meco0597/SeniorProject/Shell/DXFs/24tooth/24tooth_2.05mm_0.15mmkerf.dxf

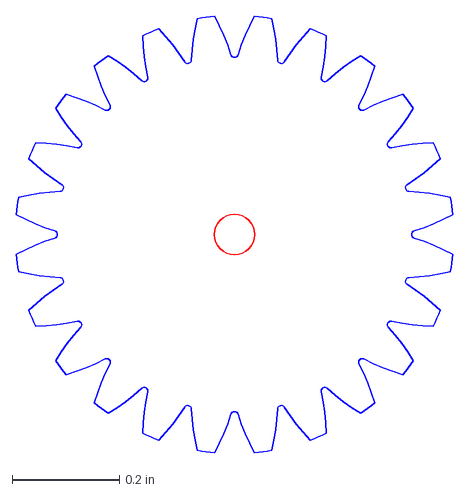
[picture p8: CAD file, 2019-11-20]
Shell/DXFs/24tooth/24tooth_2.05mm_0.15mmkerf.dxf
0.813 x 0.813 in
