meco0597/SeniorProject/Shell/Parts/Wheel_Acrylic.stl

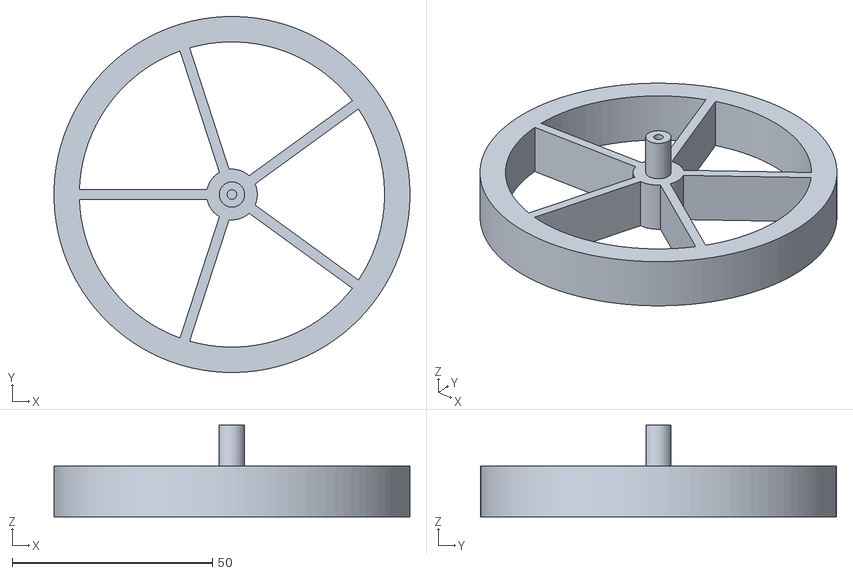
[picture p9: CAD file, 2019-11-24]
Shell/Parts/Wheel_Acrylic.stl
88.9 x 88.9 x 22.9
