meco0597/SeniorProject/Shell/STLs/Ramp.stl

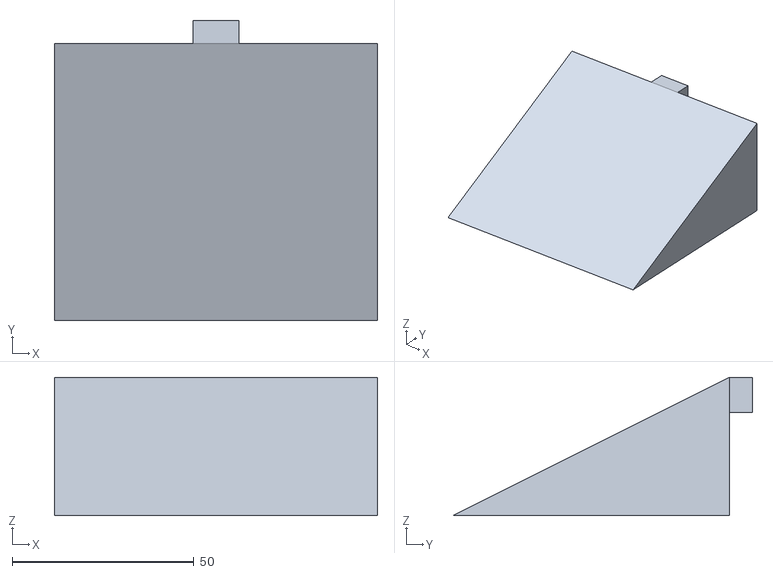
[picture p10: CAD file, 2019-12-04]
Shell/STLs/Ramp.stl
88.9 x 82.5 x 38.1
