meco0597/SeniorProject/Shell/DXFs/12tooth/12tooth_2.05mm_0.18mmkerf.dxf

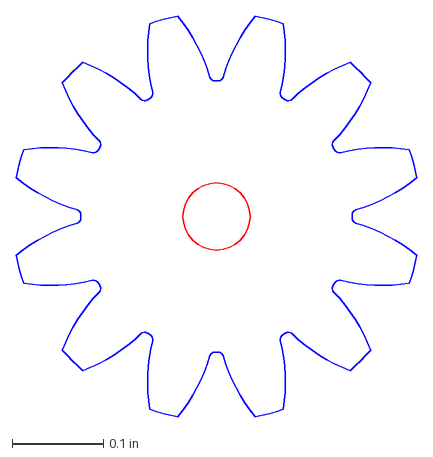
[picture p11: CAD file, 2019-11-20]
Shell/DXFs/12tooth/12tooth_2.05mm_0.18mmkerf.dxf
0.439 x 0.439 in
