meco0597/SeniorProject/Shell/Parts/GearPlate_Acrylic.stl

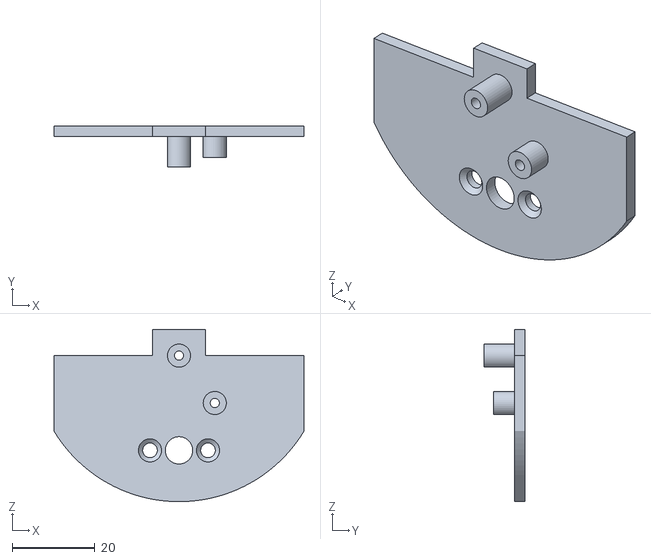
[picture p13: CAD file, 2019-11-23]
Shell/Parts/GearPlate_Acrylic.stl
60.3 x 10.0 x 41.6
