meco0597/SeniorProject/Shell/DXFs/24tooth/24tooth_2.05mm_0.18mmkerf.dxf

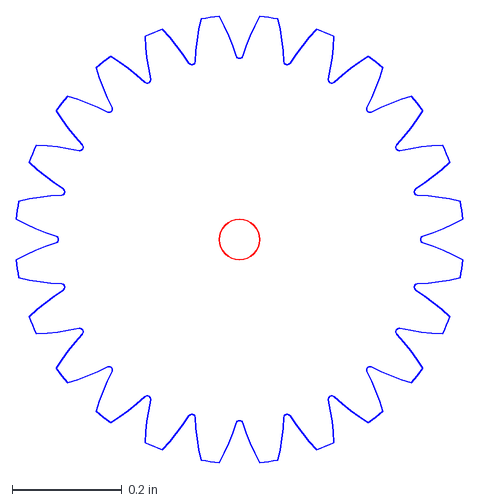
[picture p15: CAD file, 2019-11-20]
Shell/DXFs/24tooth/24tooth_2.05mm_0.18mmkerf.dxf
0.814 x 0.814 in
