meco0597/SeniorProject/Shell/STLs/GearPlateMini.stl

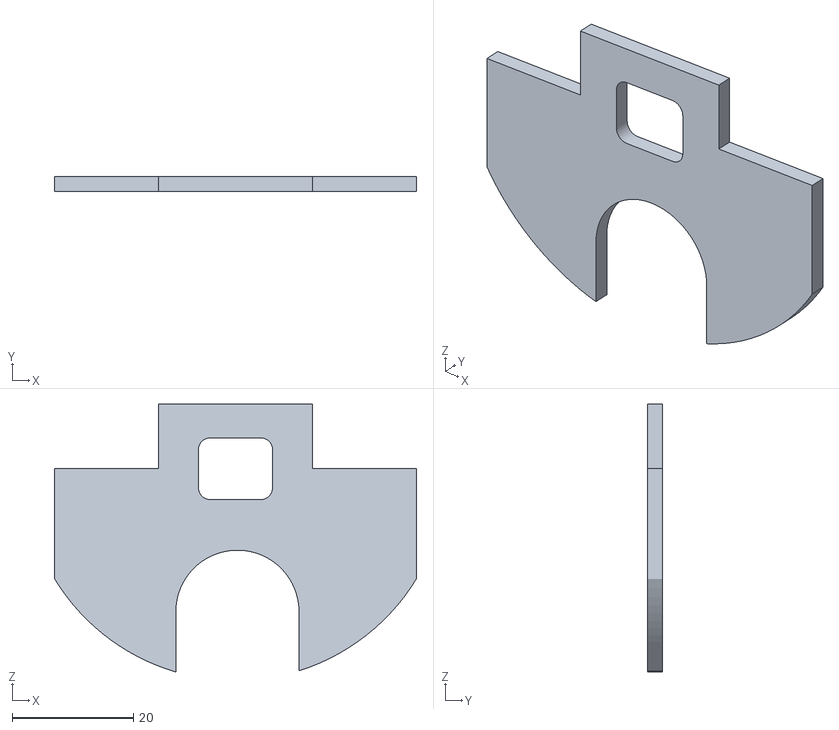
[picture p16: CAD file, 2019-12-03]
Shell/STLs/GearPlateMini.stl
59.7 x 2.54 x 44.2
