meco0597/SeniorProject/Shell/DXFs/12tooth/12tooth_0.20mmkerf.dxf

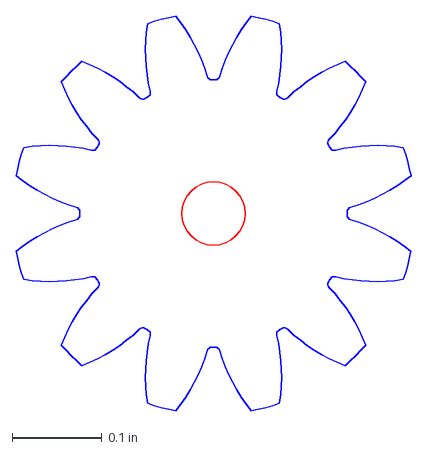
[picture p17: CAD file, 2019-11-20]
Shell/DXFs/12tooth/12tooth_0.20mmkerf.dxf
0.44 x 0.44 in
