meco0597/SeniorProject/Shell/STLs/MotorGear.stl

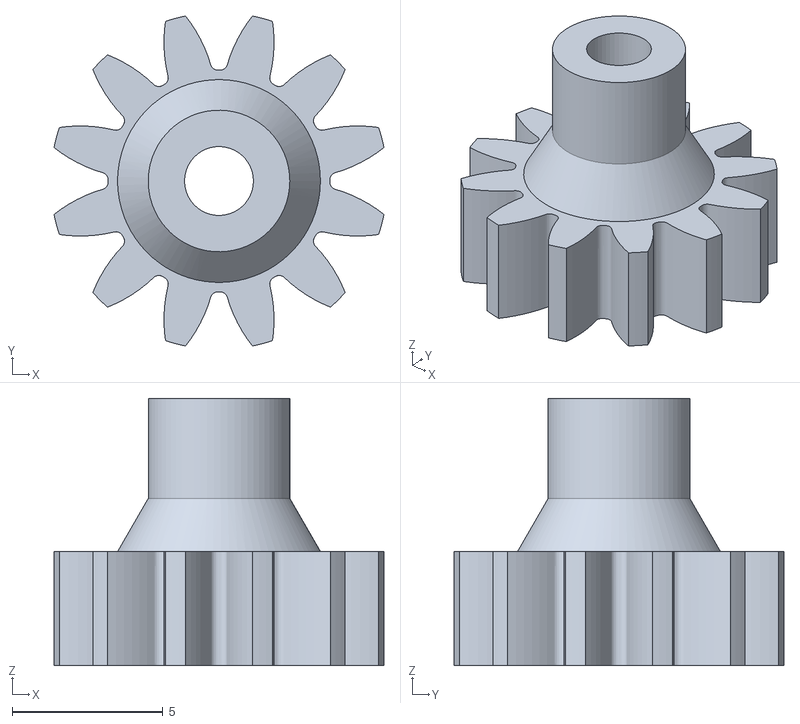
[picture p19: CAD file, 2019-11-24]
Shell/STLs/MotorGear.stl
11.0 x 11.0 x 8.88
