meco0597/SeniorProject/Shell/DXFs/12tooth/12tooth_2.05mm_0.19mmkerf.dxf

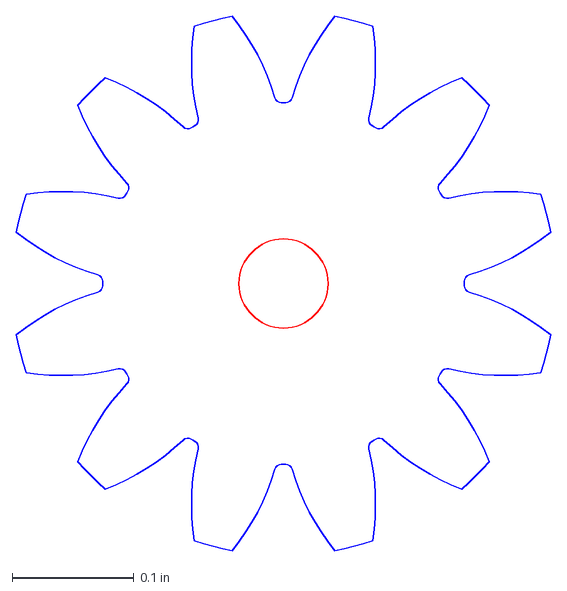
[picture p20: CAD file, 2019-11-20]
Shell/DXFs/12tooth/12tooth_2.05mm_0.19mmkerf.dxf
0.439 x 0.439 in
