meco0597/SeniorProject/Shell/STLs/ShellTop.stl

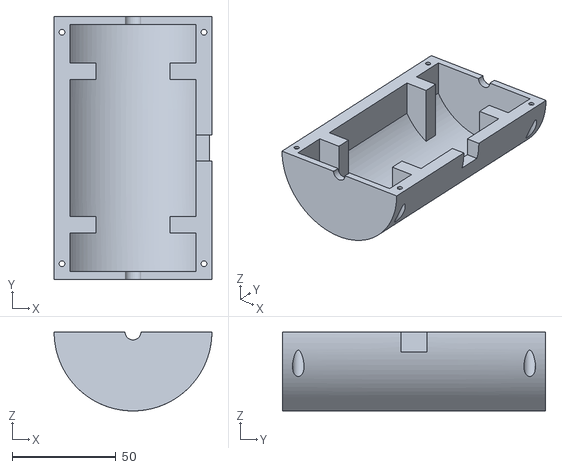
[picture p22: CAD file, 2019-11-13]
Shell/STLs/ShellTop.stl
76.2 x 127.0 x 38.1
