meco0597/SeniorProject/Shell/DXFs/24tooth/24tooth_2.05mm_0.20mmkerf.dxf

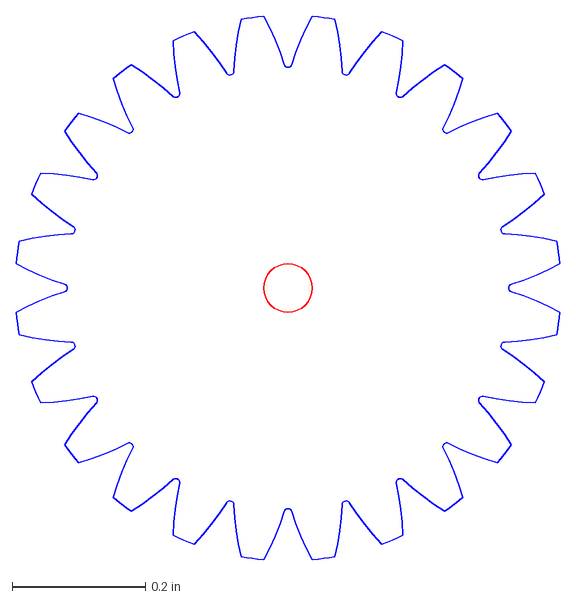
[picture p24: CAD file, 2019-11-20]
Shell/DXFs/24tooth/24tooth_2.05mm_0.20mmkerf.dxf
0.815 x 0.815 in
