meco0597/SeniorProject/Shell/STLs/ShellBottom.stl

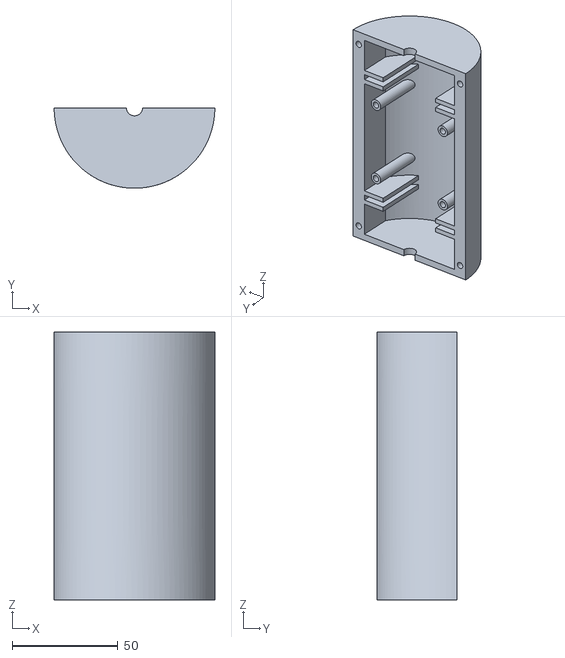
[picture p25: CAD file, 2019-11-13]
Shell/STLs/ShellBottom.stl
76.2 x 38.1 x 127.0
