meco0597/SeniorProject/Shell/DXFs/24tooth/24tooth_0.18mmkerf.dxf

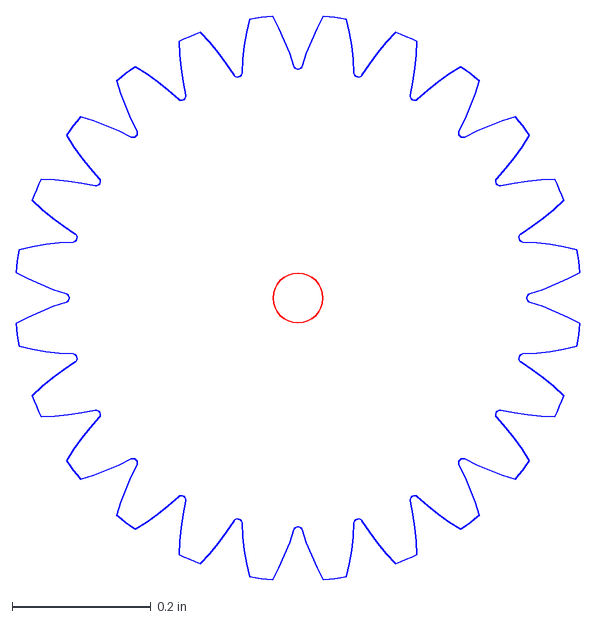
[picture p27: CAD file, 2019-11-17]
Shell/DXFs/24tooth/24tooth_0.18mmkerf.dxf
0.814 x 0.814 in
