meco0597/SeniorProject/Shell/STLs/GearSet.stl

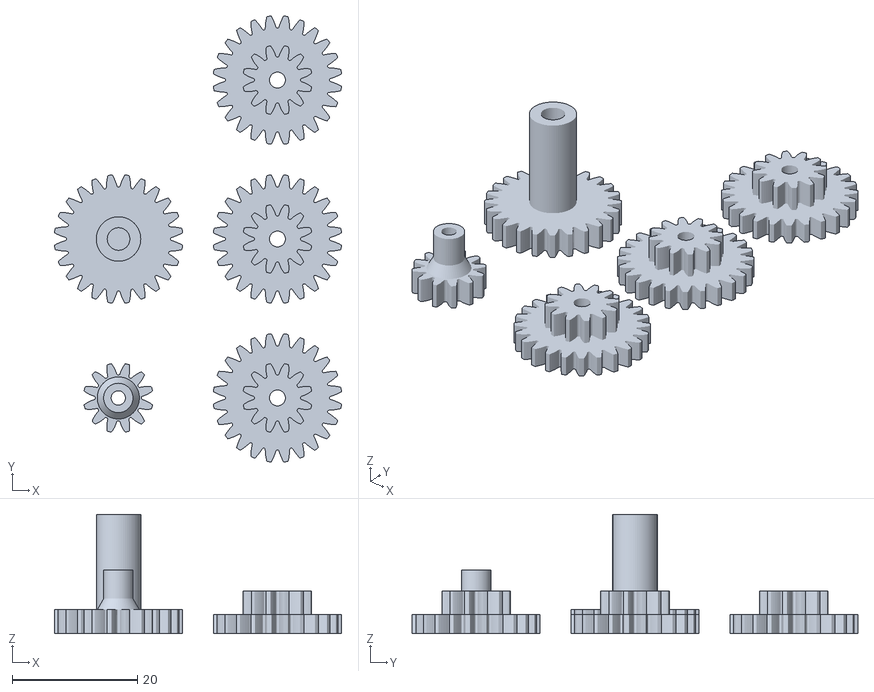
[picture p28: CAD file, 2019-11-11]
Shell/STLs/GearSet.stl
45.9 x 71.3 x 19.1
