meco0597/SeniorProject/Shell/DXFs/12tooth/12tooth_0.16mmkerf.dxf

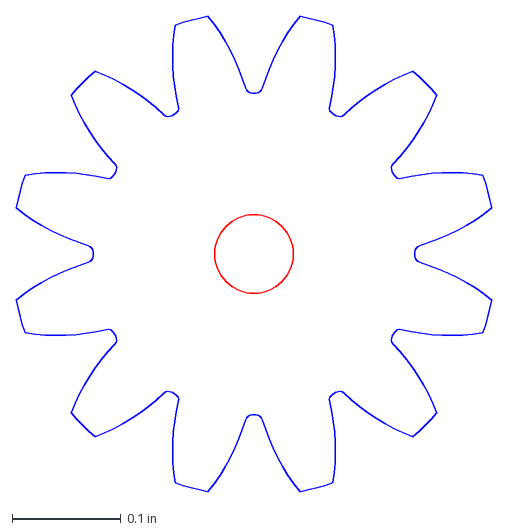
[picture p29: CAD file, 2019-11-20]
Shell/DXFs/12tooth/12tooth_0.16mmkerf.dxf
0.438 x 0.438 in
