meco0597/SeniorProject/Shell/STLs/GearPlate.stl

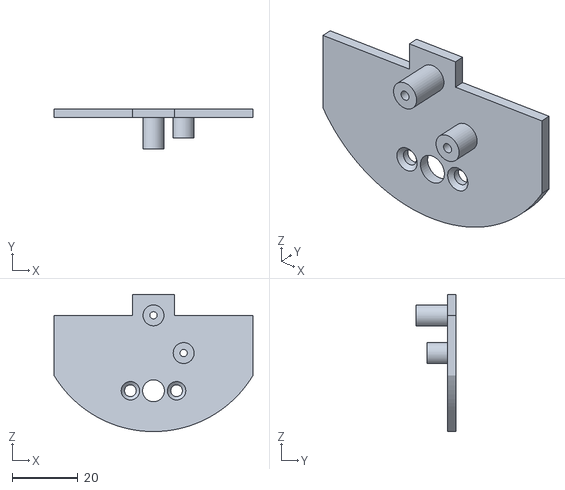
[picture p30: CAD file, 2019-11-11]
Shell/STLs/GearPlate.stl
60.3 x 12.2 x 41.6
