meco0597/SeniorProject/Shell/STLs/GearTestBoxBig.stl

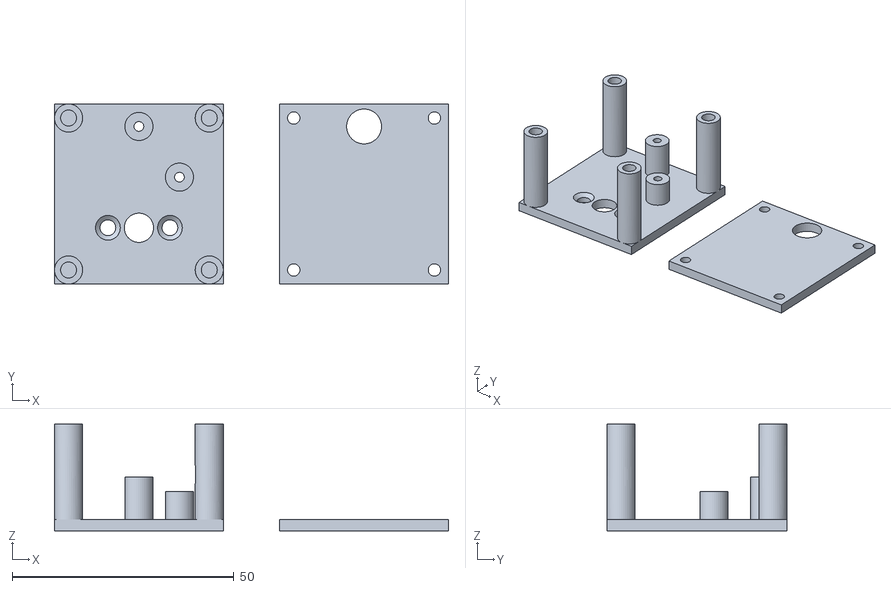
[picture p32: CAD file, 2019-11-03]
Shell/STLs/GearTestBoxBig.stl
88.9 x 40.6 x 24.1
