meco0597/SeniorProject/Shell/STLs/Wheel.stl

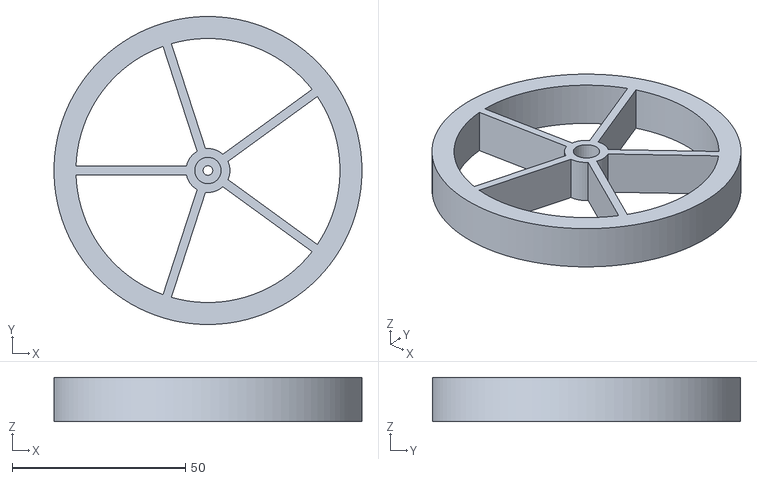
[picture p34: CAD file, 2019-11-03]
Shell/STLs/Wheel.stl
88.9 x 88.9 x 12.7
