meco0597/SeniorProject/Shell/STLs/GearTestBox.stl

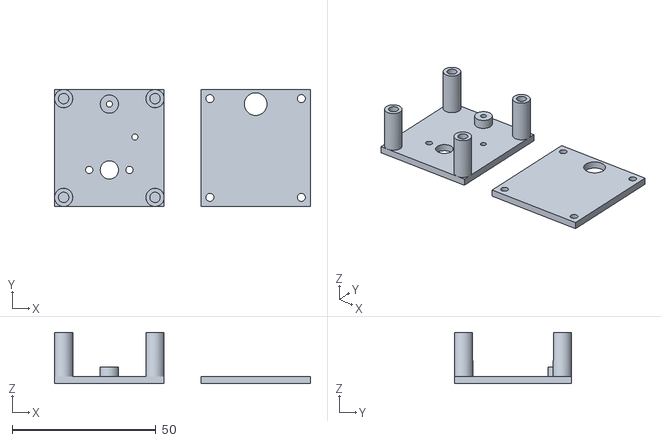
[picture p36: CAD file, 2019-10-28]
Shell/STLs/GearTestBox.stl
88.9 x 40.6 x 17.8
