meco0597/SeniorProject/Shell/DXFs/12tooth/12tooth_0.18mmkerf.dxf

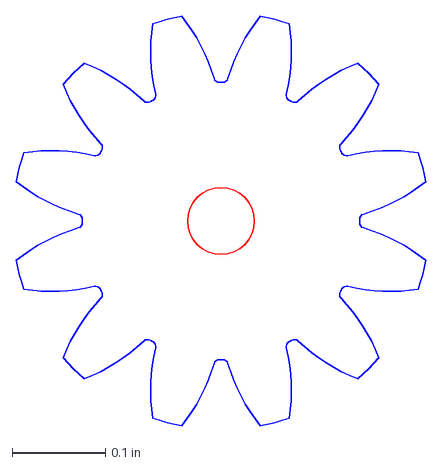
[picture p37: CAD file, 2019-11-17]
Shell/DXFs/12tooth/12tooth_0.18mmkerf.dxf
0.439 x 0.439 in
