meco0597/SeniorProject/(list of files, cad)

Other CAD files:
Shell/STLs/WheelMini.stl
Shell/4in len PowerMotor Shell.f3d
Shell/Gears/12ToothGear.f3d
Shell/Gears/24ToothGear.f3d
Shell/Gears/CompoundGear.f3z
Shell/Gears/GearSet.f3z
Shell/Gears/MotorGear.f3z
Shell/Gears/WheelGear.f3z
Shell/Parts/ShellBottom.f3d
Shell/Parts/ShellTop.f3d
Shell/Parts/Wheel.f3d
Shell/Robot Shell 3in Diameter v1.f3d
Shell/Robot Shell v1.f3d
Shell/Shell4L v1.f3d
Shell/Tests/GearTestBox.f3d
