meco0597/SeniorProject/Shell/DXFs/gearset.pdf

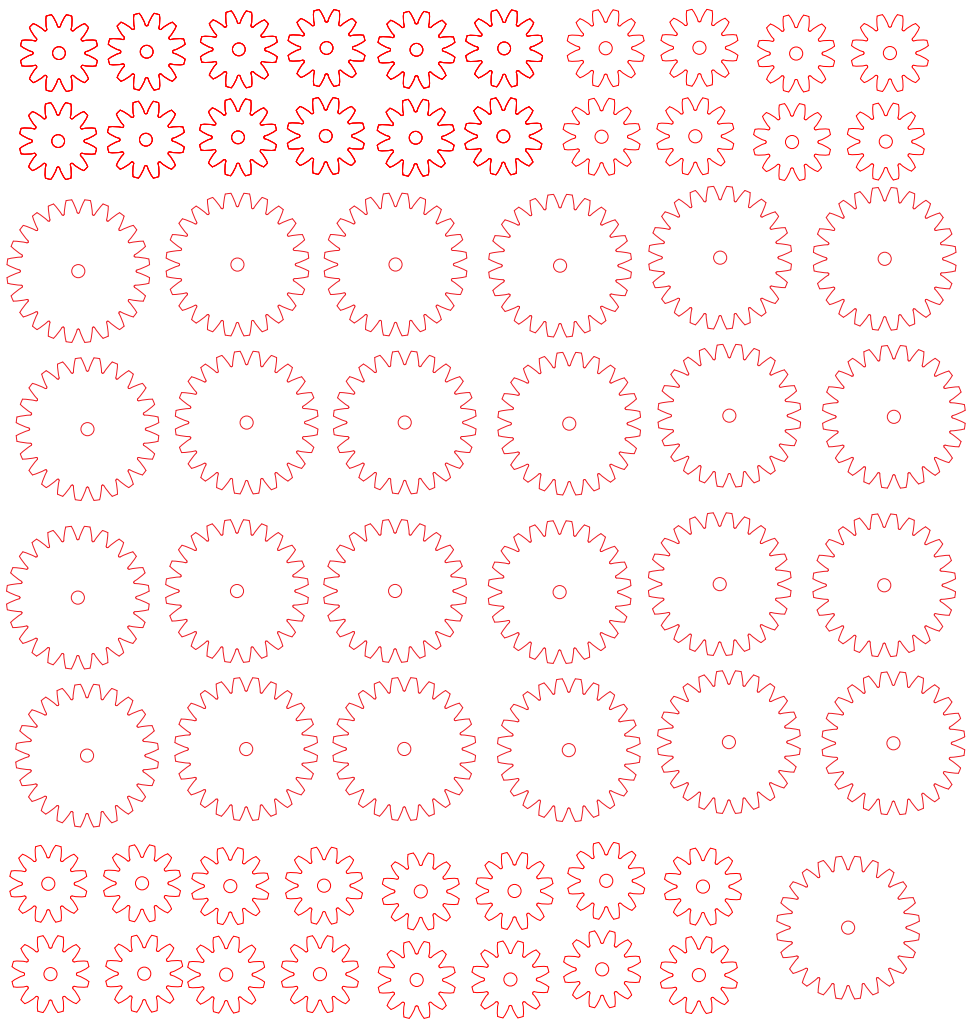
[picture p38: page 1]
