meco0597/SeniorProject/PCB/RobotPCB/RobotPCB.brd

## EAGLE design PCB/RobotPCB/RobotPCB.brd (2019-10-25)

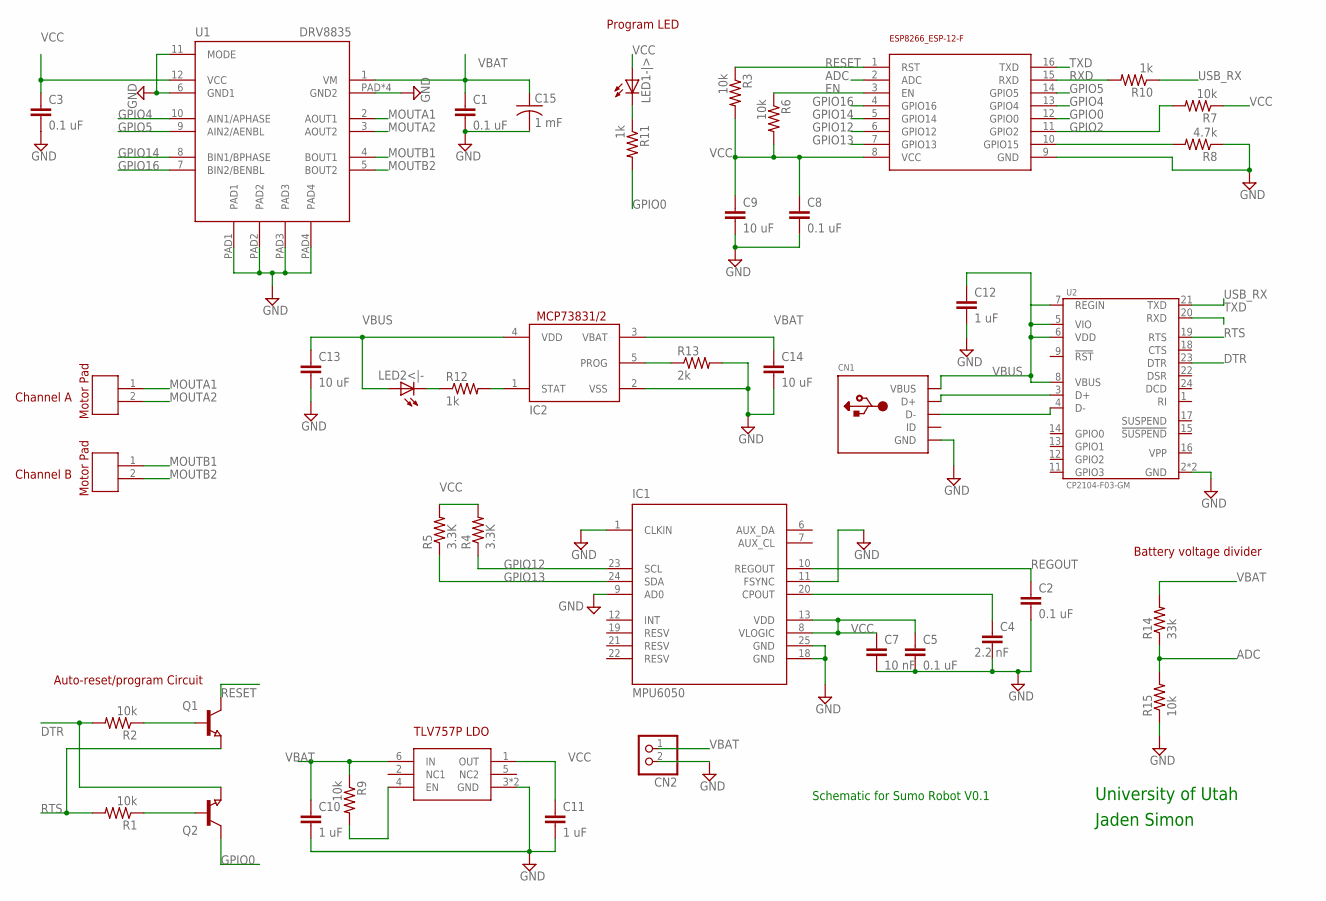
[picture p39: schematic RobotPCB.sch]

Parts:
C1, C2, C3, C5, C8: 0.1 uF; C1206
C4: 2.2 nF; C1206
C7: 10 nF; C1206
C9, C13, C14: 10 uF; C1206
C10, C11, C12: 1 uF; C1206
C15: 1 mF; C050-075X075
CN1: USBMINIB; USB-MINIB
CN2: JST_2PIN-THM; JST-PH-2-THM
IC1: MPU6050; QFN50P400X400X95-25T265X275N
IC2: MCP73831/OT; SOT23-5L
LED1-|>, LED2<|-: LEDSMT1206; 1206
Q1, Q2: NPN-TRANSISTOR_SOT23; SOT23
R1, R2, R3, R6, R7, R9, R15: 10k; M1206
R4, R5: 3.3K; M1206
R8: 4.7k; M1206
R10, R11, R12: 1k; M1206
R13: 2k; M1206
R14: 33k; M1206
U1: DRV8835; WSON_2X3
U2: CP2104-F03-GM; QFN-24-4X4
U$1: ESP8266_ESP-12; ESP8266-ESP12
U$2: TLV757P; WSON-6
U$3, U$4: MOTOR_PAD

Connections:
ADC: R14.1, R15.2, U$1.2 (ADC)
DTR: Q2.2 (E), R2.2, U2.23 (DTR)
EN: R6.1, U$1.3 (EN)
GND: C1.2, C2.2, C3.2, C4.2, C5.2, C7.2, C8.2, C9.2, C10.2, C11.2, C12.2, C13.2, C14.2, C15.2, CN1.GND, CN2.2 (1), IC1.1 (CLKIN), IC1.9 (AD0), IC1.11 (FSYNC), IC1.18 (GND), IC1.25 (GND), IC2.2 (VSS), R8.1, R13.2, R15.1, U1.6 (GND1), U1.11 (MODE), U1.PAD (GND2), U1.PAD1, U1.PAD2, U1.PAD3, U1.PAD4, U1.PAD5 (GND2), U1.PAD6 (GND2), U1.PAD7 (GND2), U2.2 (GND), U2.PAD (GND), U$1.9 (GND), U$2.3 (GND), U$2.7 (GND)
GPIO0: Q2.3 (C), R11.2, U$1.12 (GPIO0)
GPIO2: R7.2, U$1.11 (GPIO2)
GPIO4: U1.10 (AIN1/APHASE), U$1.13 (GPIO4)
GPIO5: U1.9 (AIN2/AENBL), U$1.14 (GPIO5)
GPIO12: IC1.23 (SCL), R4.1, U$1.6 (GPIO12)
GPIO13: IC1.24 (SDA), R5.1, U$1.7 (GPIO13)
GPIO14: U1.8 (BIN1/BPHASE), U$1.5 (GPIO14)
GPIO16: U1.7 (BIN2/BENBL), U$1.4 (GPIO16)
MOUTA1: U1.2 (AOUT1), U$3.1 (L)
MOUTA2: U1.3 (AOUT2), U$3.2
MOUTB1: U1.4 (BOUT1), U$4.1 (L)
MOUTB2: U1.5 (BOUT2), U$4.2
unnamed: C4.1, IC1.20 (CPOUT)
unnamed: Q1.1 (B), R2.1
unnamed: R9.2, U$2.4 (EN)
unnamed: CN1.D+, U2.3 (D+)
unnamed: Q2.1 (B), R1.1
unnamed: CN1.D-, U2.4 (D-)
unnamed: LED1-|>.C, R11.1
unnamed: IC2.5 (PROG), R13.1
unnamed: IC2.1 (STAT), R12.2
unnamed: LED2<|-.C, R12.1
unnamed: R8.2, U$1.10 (GPIO15)
REGOUT: C2.1, IC1.10 (REGOUT)
RESET: Q1.3 (C), R3.1, U$1.1 (RST)
RTS: Q1.2 (E), R1.2, U2.19 (RTS)
RXD: R10.2, U$1.15 (RXD)
TXD: U2.20 (RXD), U$1.16 (TXD)
USB_RX: R10.1, U2.21 (TXD)
VBAT: C1.1, C10.1, C14.1, C15.1, CN2.1 (2), IC2.3 (VBAT), R9.1, R14.2, U1.1 (VM), U$2.6 (IN)
VBUS: C12.1, C13.1, CN1.VBUS, IC2.4 (VDD), LED2<|-.A, U2.5 (VIO), U2.6 (VDD), U2.7 (REGIN), U2.8 (VBUS)
VCC: C3.1, C5.1, C7.1, C8.1, C9.1, C11.1, IC1.8 (VLOGIC), IC1.13 (VDD), LED1-|>.A, R3.2, R4.2, R5.2, R6.2, R7.1, U1.12 (VCC), U$1.8 (VCC), U$2.1 (OUT)

Notes on the sheet:
University of Utah
Jaden Simon
Schematic for Sumo Robot V0.1
Auto-reset/program Circuit
Program LED
Battery voltage divider
Channel A
Channel B

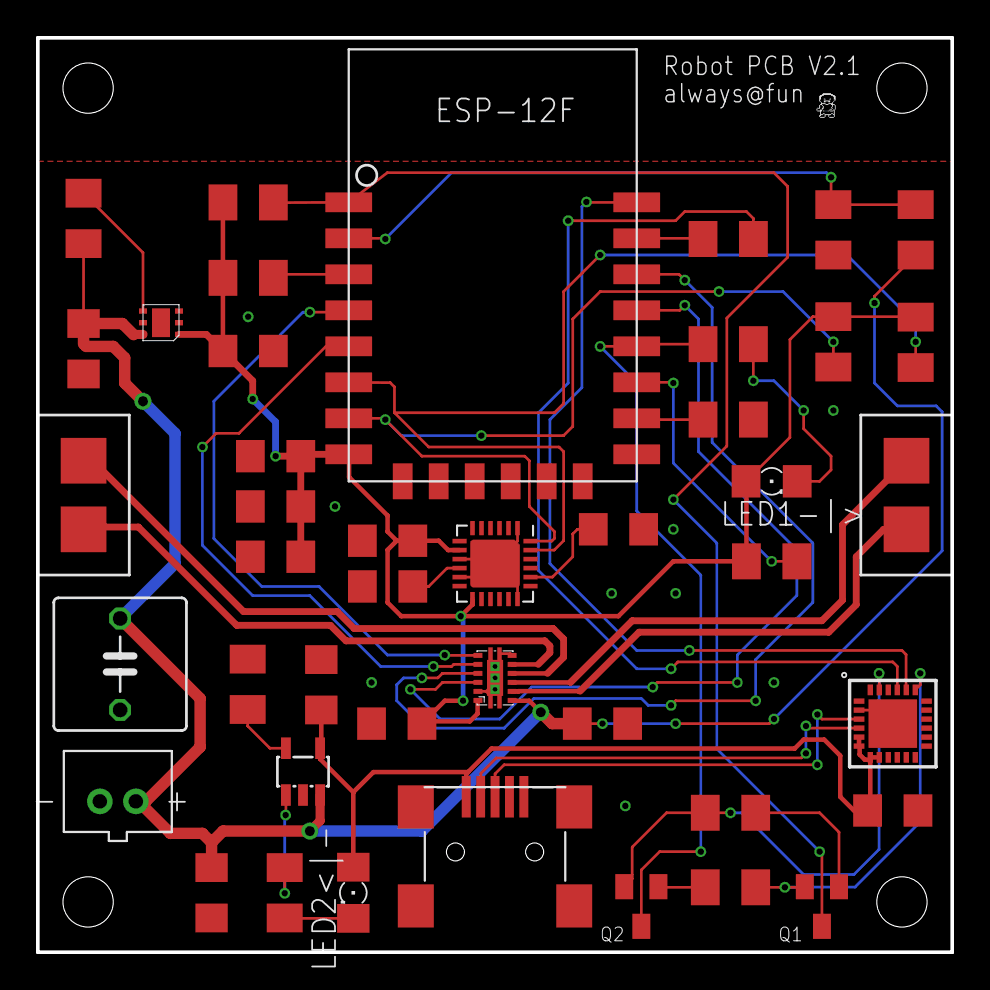
[picture p40: board RobotPCB.brd from above]

Board: 2 copper layers, 50.8 x 50.8 mm, 43 parts (0 on the bottom side), 36 nets.
