meco0597/SeniorProject/Hub/WiiController/bluez-5.52/mesh/mesh-defs.h

/*
 *
 *  BlueZ - Bluetooth protocol stack for Linux
 *
 *  Copyright (C) 2018-2019  Intel Corporation. All rights reserved.
 *
 *
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
 *
 */

#define MESH_AD_TYPE_PROVISION	0x29
#define MESH_AD_TYPE_NETWORK	0x2A
#define MESH_AD_TYPE_BEACON	0x2B

#define FEATURE_RELAY	1
#define FEATURE_PROXY	2
#define FEATURE_FRIEND	4
#define FEATURE_LPN	8

#define MESH_MODE_DISABLED	0
#define MESH_MODE_ENABLED	1
#define MESH_MODE_UNSUPPORTED	2

#define KEY_REFRESH_PHASE_NONE	0x00
#define KEY_REFRESH_PHASE_ONE	0x01
#define KEY_REFRESH_PHASE_TWO	0x02
#define KEY_REFRESH_PHASE_THREE	0x03

#define DEFAULT_TTL		0xff
#define TTL_MASK		0x7f

/* Supported algorithms for provisioning */
#define ALG_FIPS_256_ECC	0x0001

/* Input OOB action bit flags */
#define OOB_IN_PUSH	0x0001
#define OOB_IN_TWIST	0x0002
#define OOB_IN_NUMBER	0x0004
#define OOB_IN_ALPHA	0x0008

/* Output OOB action bit flags */
#define OOB_OUT_BLINK	0x0001
#define OOB_OUT_BEEP	0x0002
#define OOB_OUT_VIBRATE	0x0004
#define OOB_OUT_NUMBER	0x0008
#define OOB_OUT_ALPHA	0x0010

/* Status codes */
#define MESH_STATUS_SUCCESS		0x00
#define MESH_STATUS_INVALID_ADDRESS	0x01
#define MESH_STATUS_INVALID_MODEL	0x02
#define MESH_STATUS_INVALID_APPKEY	0x03
#define MESH_STATUS_INVALID_NETKEY	0x04
#define MESH_STATUS_INSUFF_RESOURCES	0x05
#define MESH_STATUS_IDX_ALREADY_STORED	0x06
#define MESH_STATUS_INVALID_PUB_PARAM	0x07
#define MESH_STATUS_NOT_SUB_MOD		0x08
#define MESH_STATUS_STORAGE_FAIL	0x09
#define MESH_STATUS_FEATURE_NO_SUPPORT	0x0a
#define MESH_STATUS_CANNOT_UPDATE	0x0b
#define MESH_STATUS_CANNOT_REMOVE	0x0c
#define MESH_STATUS_CANNOT_BIND		0x0d
#define MESH_STATUS_UNABLE_CHANGE_STATE	0x0e
#define MESH_STATUS_CANNOT_SET		0x0f
#define MESH_STATUS_UNSPECIFIED_ERROR	0x10
#define MESH_STATUS_INVALID_BINDING	0x11

#define UNASSIGNED_ADDRESS	0x0000
#define PROXIES_ADDRESS	0xfffc
#define FRIENDS_ADDRESS	0xfffd
#define RELAYS_ADDRESS		0xfffe
#define ALL_NODES_ADDRESS	0xffff
#define VIRTUAL_ADDRESS_LOW	0x8000
#define VIRTUAL_ADDRESS_HIGH	0xbfff
#define GROUP_ADDRESS_LOW	0xc000
#define GROUP_ADDRESS_HIGH	0xfeff
#define FIXED_GROUP_LOW		0xff00
#define FIXED_GROUP_HIGH	0xffff

#define NODE_IDENTITY_STOPPED		0x00
#define NODE_IDENTITY_RUNNING		0x01
#define NODE_IDENTITY_NOT_SUPPORTED	0x02

#define PRIMARY_ELE_IDX		0x00

#define PRIMARY_NET_IDX		0x0000
#define MAX_KEY_IDX		0x0fff
#define MAX_MODEL_COUNT		0xff
#define MAX_ELE_COUNT		0xff

#define MAX_MSG_LEN		380

#define VENDOR_ID_MASK		0xffff0000

#define NET_IDX_INVALID	0xffff
#define NET_NID_INVALID	0xff

#define APP_IDX_MASK		0x0fff
#define APP_IDX_DEV_REMOTE	0x6fff
#define APP_IDX_DEV_LOCAL	0x7fff

#define IS_UNASSIGNED(x)	((x) == UNASSIGNED_ADDRESS)
#define IS_UNICAST(x)		(((x) > UNASSIGNED_ADDRESS) && \
					((x) < VIRTUAL_ADDRESS_LOW))
#define IS_UNICAST_RANGE(x, c)	(IS_UNICAST(x) && IS_UNICAST(x + c - 1))
#define IS_VIRTUAL(x)		(((x) >= VIRTUAL_ADDRESS_LOW) && \
					((x) <= VIRTUAL_ADDRESS_HIGH))
#define IS_GROUP(x)		((((x) >= GROUP_ADDRESS_LOW) && \
					((x) < FIXED_GROUP_HIGH)) || \
					((x) == ALL_NODES_ADDRESS))

#define IS_FIXED_GROUP_ADDRESS(x)	((x) >= PROXIES_ADDRESS)
#define IS_ALL_NODES(x)	((x) == ALL_NODES_ADDRESS)
