meco0597/SeniorProject/Hub/WiiController/bluez-5.52/mesh/main.c

/*
 *
 *  BlueZ - Bluetooth protocol stack for Linux
 *
 *  Copyright (C) 2017-2019  Intel Corporation. All rights reserved.
 *
 *
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
 */

#ifdef HAVE_CONFIG_H
#include <config.h>
#endif

#define _GNU_SOURCE
#include <getopt.h>
#include <stdlib.h>
#include <unistd.h>
#include <ctype.h>

#include <sys/stat.h>
#include <ell/ell.h>

#include "lib/bluetooth.h"
#include "lib/mgmt.h"

#include "mesh/mesh.h"
#include "mesh/crypto.h"
#include "mesh/dbus.h"
#include "mesh/mesh-io.h"

static const struct option main_options[] = {
	{ "index",	required_argument,	NULL, 'i' },
	{ "config",	optional_argument,	NULL, 'c' },
	{ "nodetach",	no_argument,		NULL, 'n' },
	{ "debug",	no_argument,		NULL, 'd' },
	{ "dbus-debug",	no_argument,		NULL, 'b' },
	{ "help",	no_argument,		NULL, 'h' },
	{ }
};

static void usage(void)
{
	l_info("");
	l_info("Usage:\n"
	       "\tbluetooth-meshd [options]\n");
	l_info("Options:\n"
	       "\t--index <hcinum>  Use specified controller\n"
	       "\t--config          Configuration directory\n"
	       "\t--nodetach        Run in foreground\n"
	       "\t--debug           Enable debug output\n"
	       "\t--dbus-debug      Enable D-Bus debugging\n"
	       "\t--help            Show %s information\n", __func__);
}

static void do_debug(const char *str, void *user_data)
{
	const char *prefix = user_data;

	l_info("%s%s", prefix, str);
}

static void request_name_callback(struct l_dbus *dbus, bool success,
					bool queued, void *user_data)
{
	l_info("Request name %s",
		success ? "success": "failed");

	if (success)
		dbus_init(dbus);
	else
		l_main_quit();
}

static void ready_callback(void *user_data)
{
	struct l_dbus *dbus = user_data;

	l_info("D-Bus ready");
	l_dbus_name_acquire(dbus, BLUEZ_MESH_NAME, false, false, false,
						request_name_callback, NULL);

}

static void disconnect_callback(void *user_data)
{
	l_main_quit();
}

static void signal_handler(uint32_t signo, void *user_data)
{
	static bool terminated;

	if (terminated)
		return;

	l_info("Terminating");
	l_main_quit();
	terminated = true;
}

int main(int argc, char *argv[])
{
	int status;
	bool detached = true;
	bool dbus_debug = false;
	struct l_dbus *dbus = NULL;
	const char *config_dir = NULL;
	int index = MGMT_INDEX_NONE;

	if (!l_main_init())
		return -1;

	l_log_set_stderr();

	if (!mesh_crypto_check_avail()) {
		l_error("Mesh Crypto functions unavailable");
		status = l_main_run_with_signal(signal_handler, NULL);
		goto done;
	}

	for (;;) {
		int opt;
		const char *str;

		opt = getopt_long(argc, argv, "i:c:ndbh", main_options, NULL);
		if (opt < 0)
			break;

		switch (opt) {
		case 'i':
			if (strlen(optarg) > 3 && !strncmp(optarg, "hci", 3))
				str = optarg + 3;
			else
				str = optarg;
			if (!isdigit(*str)) {
				l_error("Invalid controller index value");
				status = EXIT_FAILURE;
				goto done;
			}

			index = atoi(str);

			break;
		case 'n':
			detached = false;
			break;
		case 'd':
			l_debug_enable("*");
			break;
		case 'c':
			config_dir = optarg;
			break;
		case 'b':
			dbus_debug = true;
			break;
		case 'h':
			usage();
			status = EXIT_SUCCESS;
			goto done;
		default:
			usage();
			status = EXIT_FAILURE;
			goto done;
		}
	}


	if (!mesh_init(config_dir, MESH_IO_TYPE_GENERIC, &index)) {
		l_error("Failed to initialize mesh");
		status = EXIT_FAILURE;
		goto done;
	}

	if (!detached)
		umask(0077);

	dbus = l_dbus_new_default(L_DBUS_SYSTEM_BUS);
	if (!dbus) {
		l_error("unable to connect to D-Bus");
		status = EXIT_FAILURE;
		goto done;
	}

	if (dbus_debug)
		l_dbus_set_debug(dbus, do_debug, "[DBUS] ", NULL);
	l_dbus_set_ready_handler(dbus, ready_callback, dbus, NULL);
	l_dbus_set_disconnect_handler(dbus, disconnect_callback, NULL, NULL);

	if (!l_dbus_object_manager_enable(dbus, "/")) {
		l_error("Failed to enable Object Manager");
		status = EXIT_FAILURE;
		goto done;
	}

	status = l_main_run_with_signal(signal_handler, NULL);

done:
	mesh_cleanup();
	l_dbus_destroy(dbus);
	l_main_exit();

	return status;
}
