meco0597/SeniorProject/(commit log)

2019-08-28 Added corrected PCB w/ values
    [RobotPCB.brd, RobotPCB.sch]
2019-09-03 Added custom driver
2019-09-03 Started some mounting holes
    [RobotPCB.brd]
2019-09-14 Optimized Robot PCB
    [RobotPCB.brd, RobotPCB.sch]
2019-09-17 Added motor throttling
2019-09-18 Added shell design
    [Robot Shell v1.f3d]
2019-09-18 2.5" Shell design
    [Robot Shell v1.f3d]
2019-09-18 3" Diameter shell
    [Robot Shell 3in Diameter v1.f3d]
2019-09-19 fixed the color detection.
    [colorDetection.py]
2019-09-26 Added new Shell 4in length 3in diameter
    [Shell4L v1.f3d]
2019-10-07 Added weekly logs so we can keep track of our doings
2019-10-15 added txt for motor dimensions
2019-10-15 Added section for motors to rest
    [Shell4L v1.f3d]
2019-10-16 Added shell w/out small motor resting platform
    [4in len PowerMotor Shell.f3d]
2019-10-17 Added some gear files
    [gear1.f3d, gear2.f3d]
2019-10-17 Added motor mounts
    [4in len PowerMotor Shell.f3d]
2019-10-19 Finished Shell :)
    [12ToothGear.f3d, 24ToothGear.f3d, CompoundGear.f3z, GearSet.f3z, GearSet.stl, GearTestBox.f3d, GearTestBox.stl, MotorGear.f3z]
2019-10-23 Embiggened Holes
    [GearSet.stl]
2019-10-24 Added battery voltage scaling
2019-10-24 Fixed gear test box
    [GearTestBox.stl]
2019-10-24 Fixed PCB mounting holes
    [RobotPCB.brd, RobotPCB.sch]
2019-10-25 Finalized Robot PCB
    [RobotPCB.brd, RobotPCB.sch]
2019-10-25 Added thermal via tenting
    [RobotPCB.brd, RobotPCB.sch]
2019-10-28 Updated test box to use screws
    [GearTestBox.f3d, GearTestBox.stl]
2019-10-29 Slightly changed gear set + big test box
    [GearSet.stl, GearTestBoxBig.stl]
2019-10-30 Adjusted hole sizes
    [GearSet.stl, GearTestBoxBig.stl]
2019-11-03 Slightly changed test box
    [GearSet.stl, GearTestBoxBig.stl, MotorGear.stl, Wheel.stl]
2019-11-07 Pushing for bricked Raspberry Pi
2019-11-11 Added gear plate to shell
    [GearPlate.stl, GearSet.stl, ShellBottom.stl, ShellTop.stl]
2019-11-12 Added txt with all board addresses
2019-11-13 Increased shell length by 0.5 inches
    [ShellBottom.stl, ShellTop.stl]
2019-11-17 Added laser cutting files
    [12tooth_0.18mmkerf.dxf, 24tooth_0.18mmkerf.dxf]
2019-11-20 Kerf tests
    [12tooth_0.15mmkerf.dxf, 12tooth_0.16mmkerf.dxf, 12tooth_0.17mmkerf.dxf, 12tooth_0.18mmkerf.dxf, 12tooth_0.19mmkerf.dxf, 12tooth_0.20mmkerf.dxf, 12tooth_2.05mm_0.15mmkerf.dxf, 12tooth_2.05mm_0.16mmkerf.dxf]
2019-11-21 Added updated gear plates/wheels
    [GearPlate_Acrylic.stl, Wheel_Acrylic.stl]
2019-11-21 New gearset
2019-11-23 new gears
2019-11-23 New gears and more of them
2019-11-23 Moved axle
    [GearPlate_Acrylic.stl]
2019-11-24 Shrunk wheel axle
    [Wheel_Acrylic.stl]
2019-11-24 Added gcode
    [MotorGear.stl]
2019-12-01 Added gear plate for mini motor
    [GearPlateMini.stl]
2019-12-03 Updated wheel/gear plate
    [GearPlateMini.stl, WheelMini.stl]
2019-12-10 pushing all of the raspberry pi code
2019-12-10 Added BOM nice report dan <3
2019-12-13 Edited BOM section
